skyterrace/Robot/MainBoard/Doc/MainBord_PortAssign.pdf

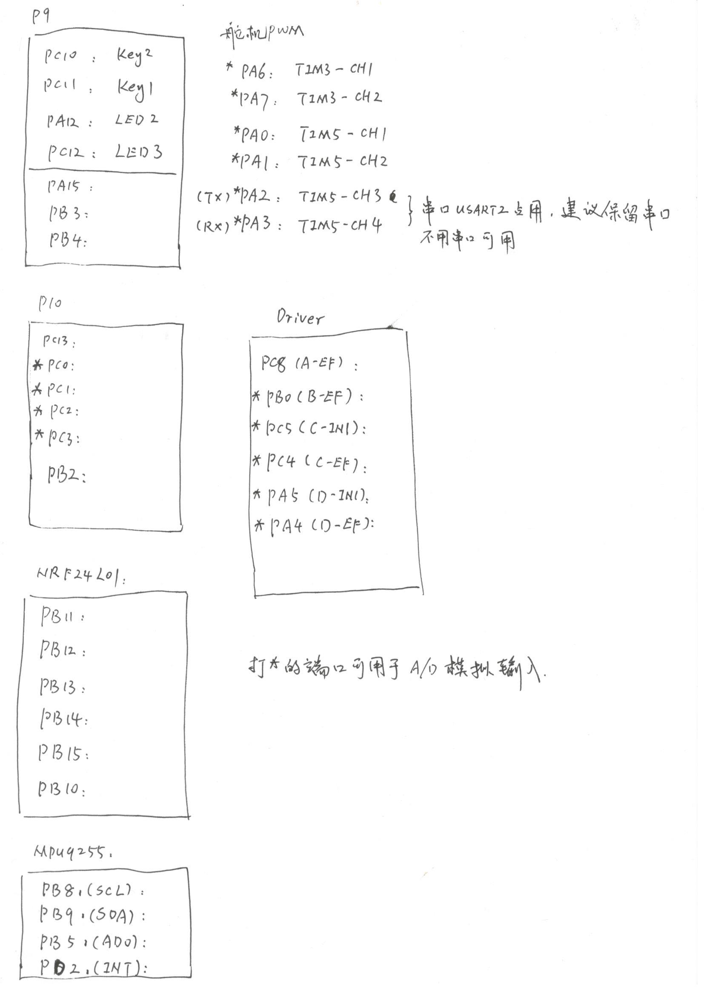
[picture p2: page 1]
