skyterrace/Robot/MainBoard/Hardware/MainBoardV2.PDF

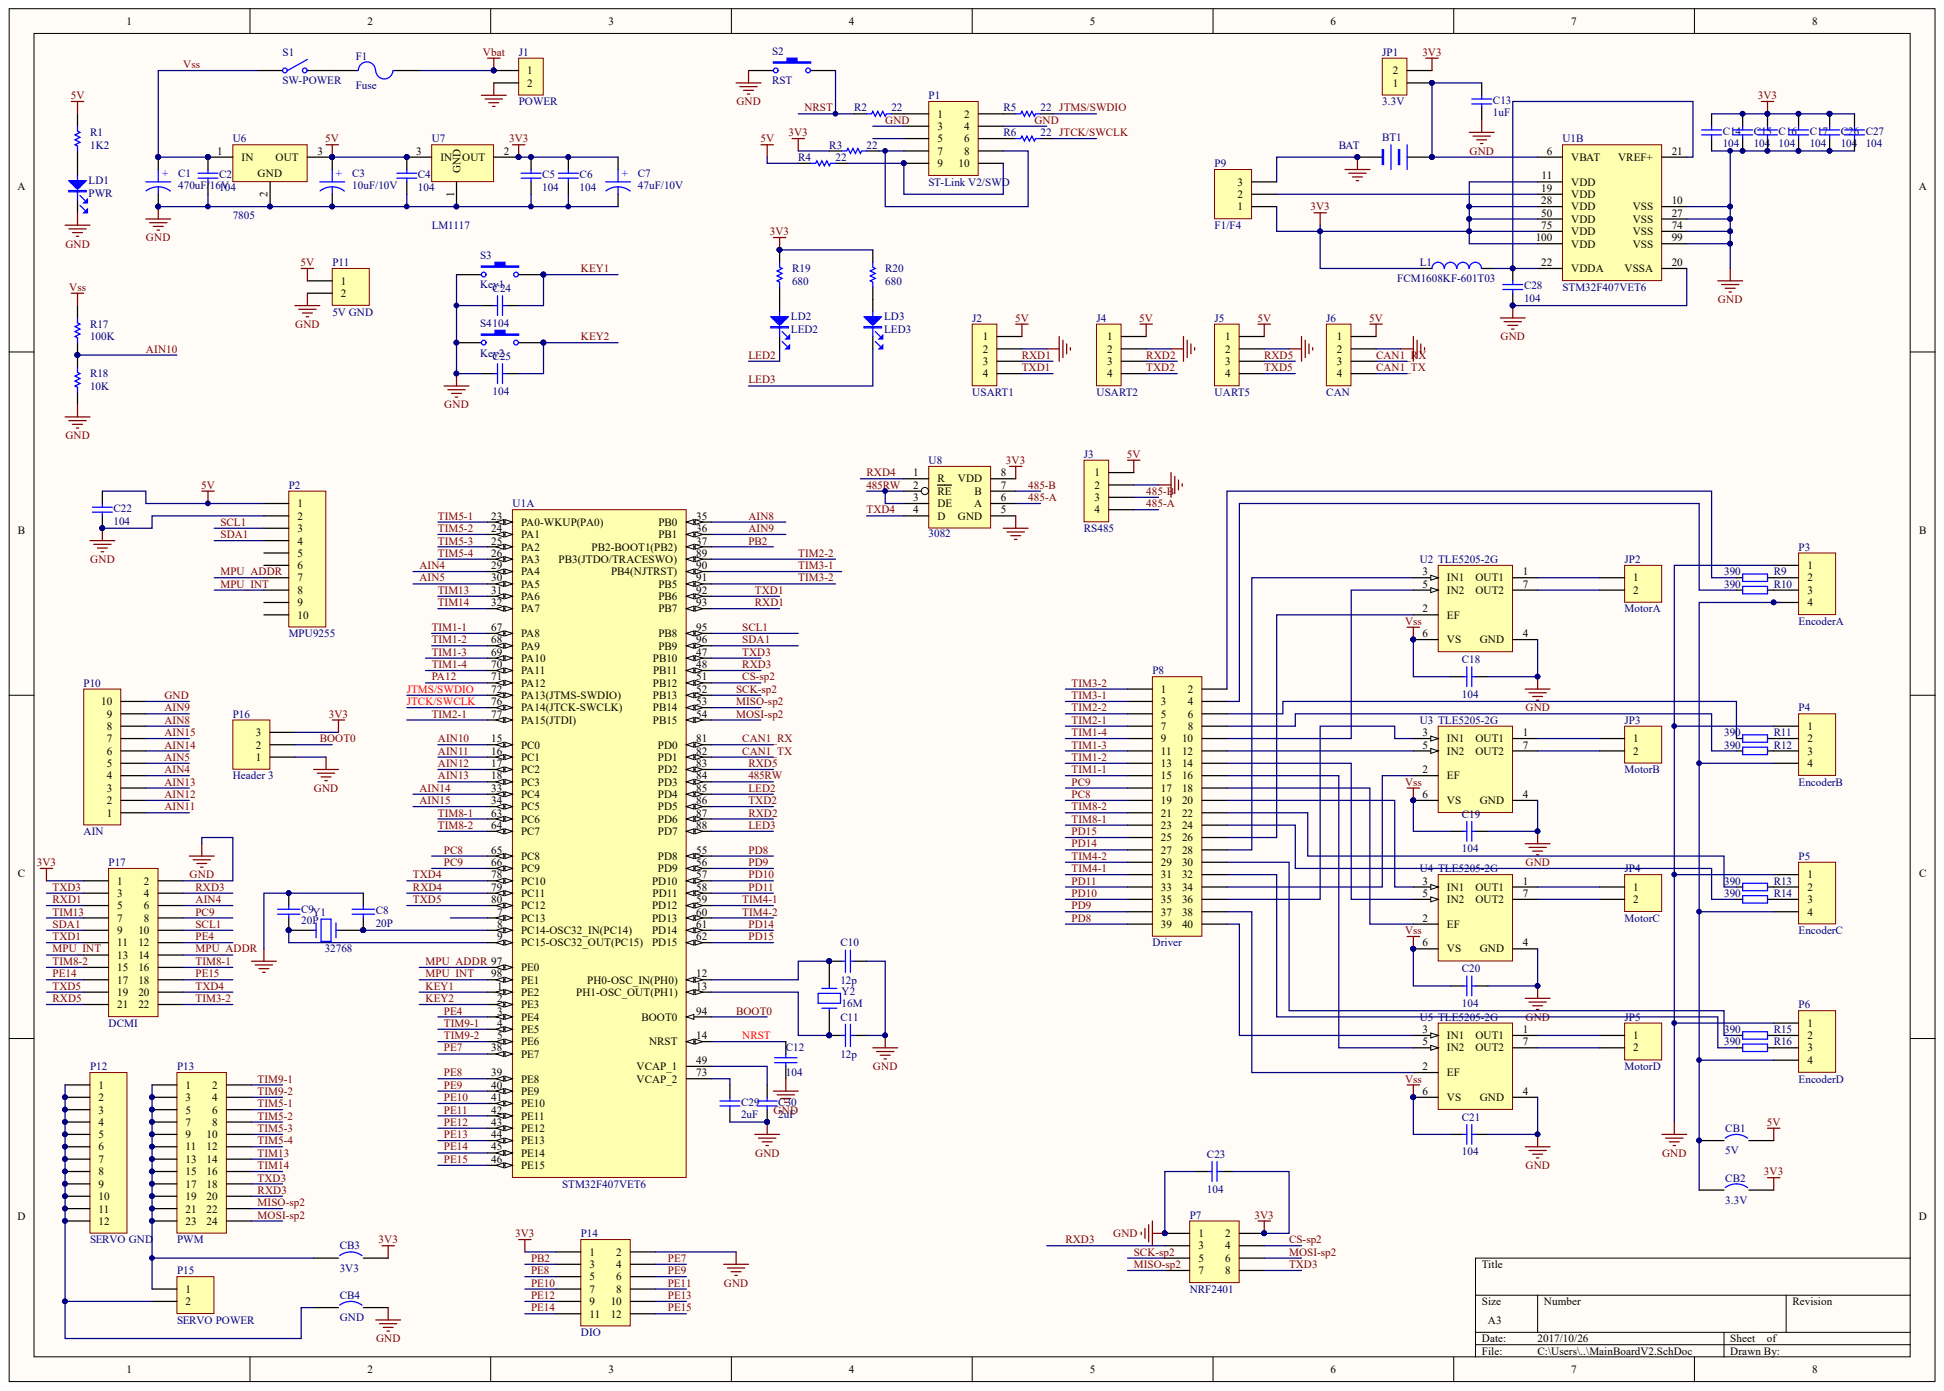
[picture p5: page 1]

VDD 50

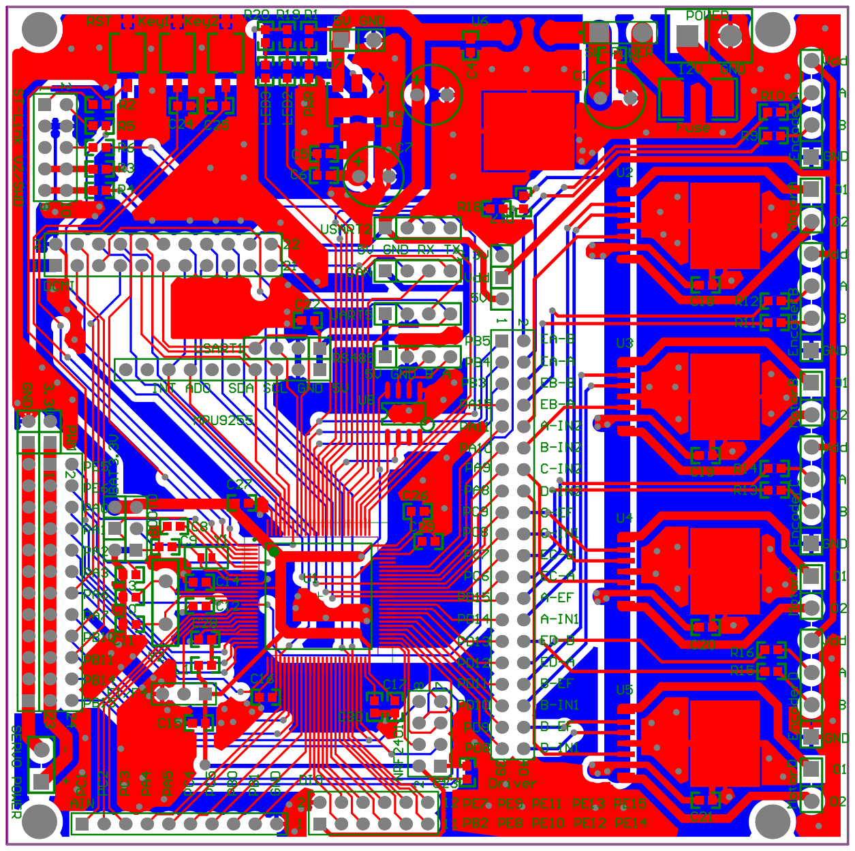
[picture p6: page 2]
