skyterrace/Robot/MainBoard/Hardware/MainBoard.PDF

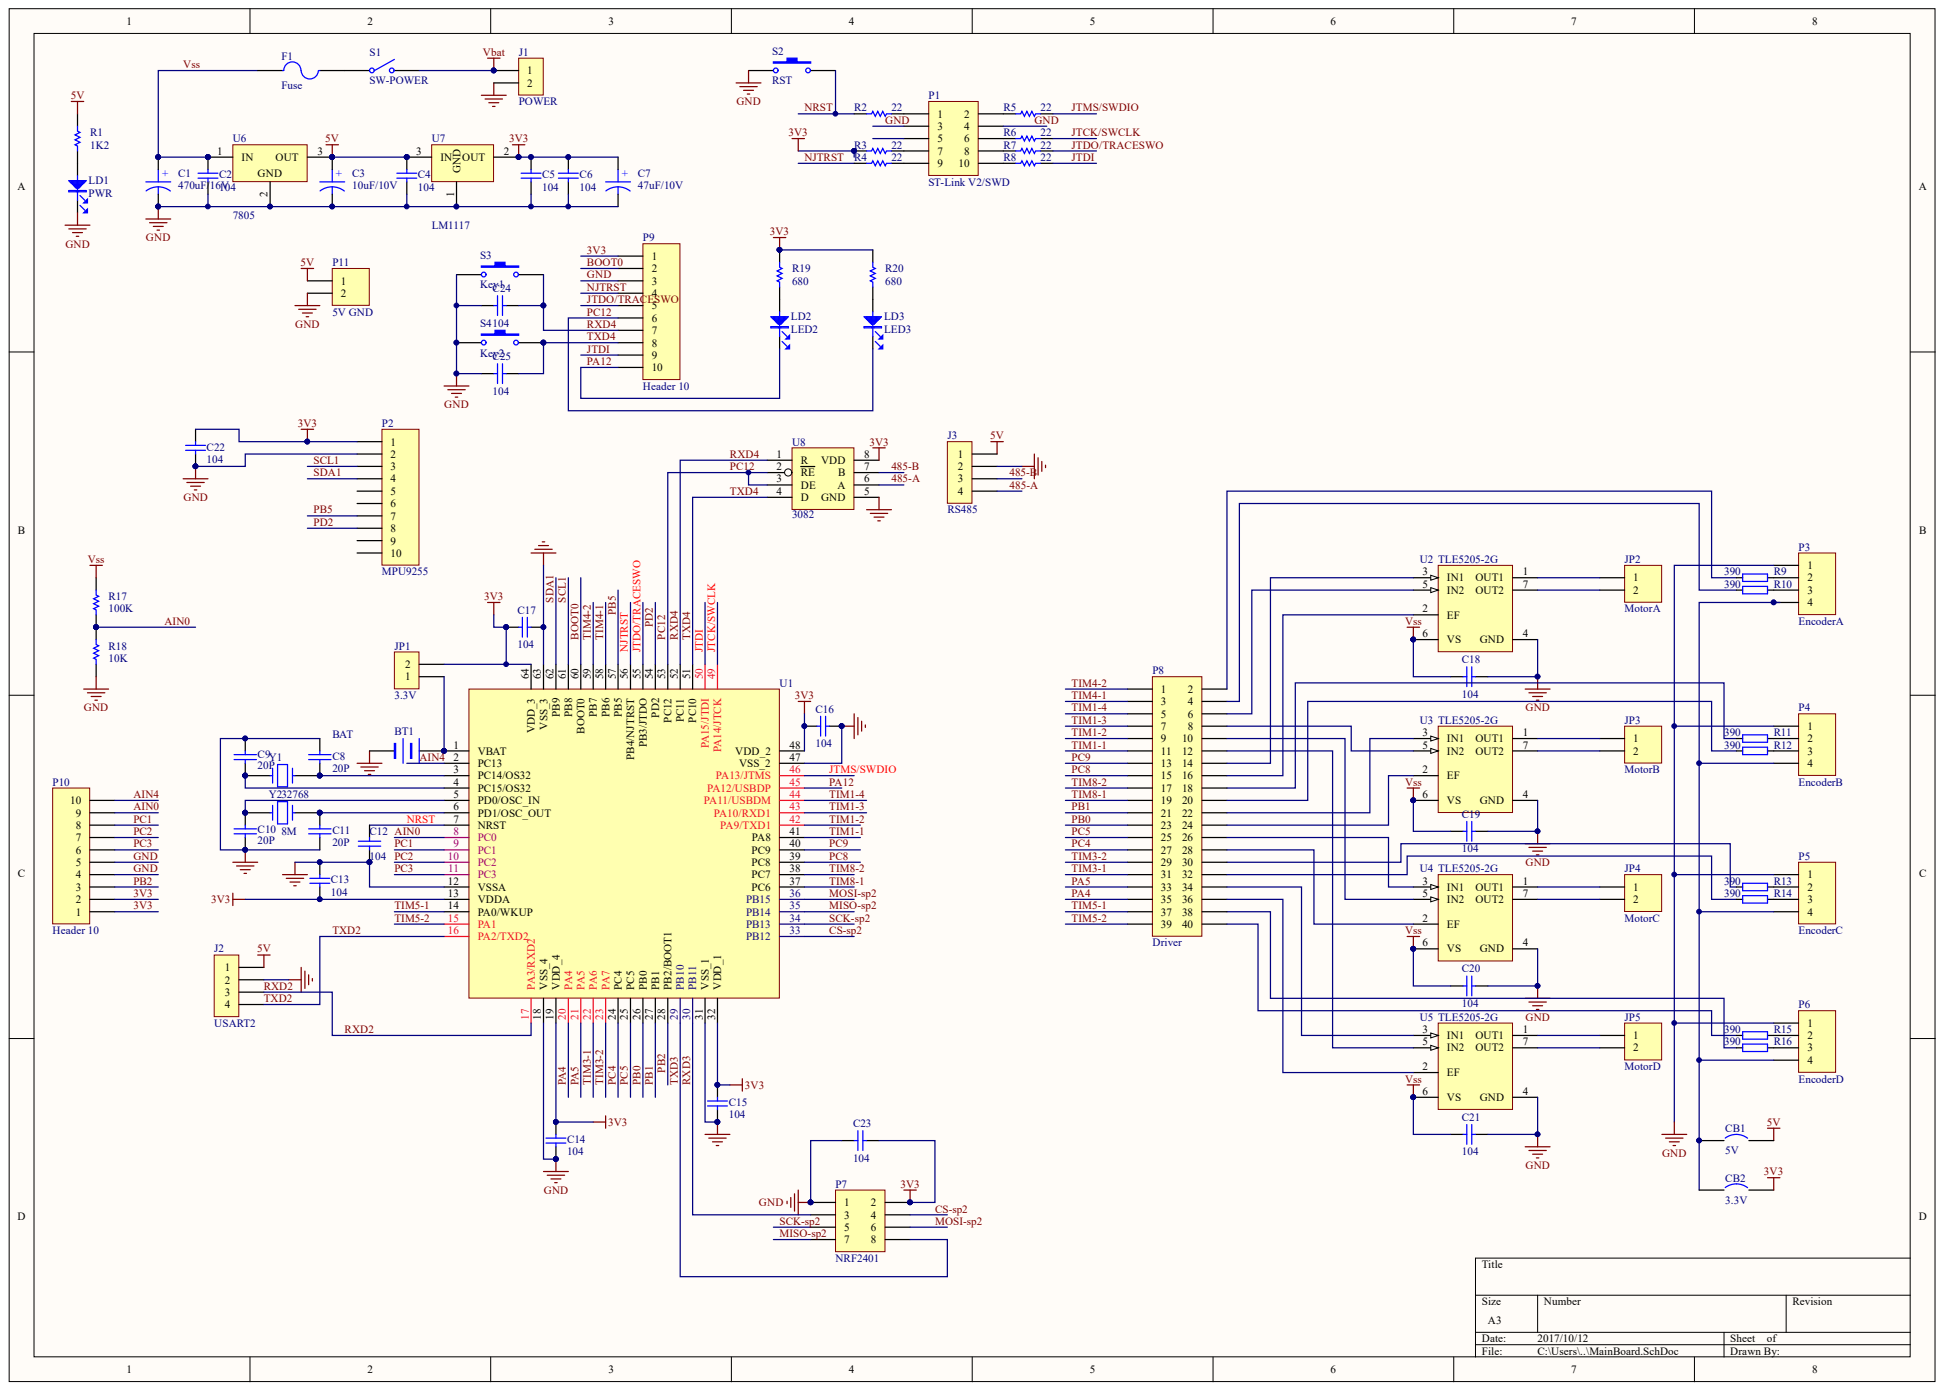
[picture p7: page 1]

PC12
RX D 4

JTD I | 10

104 SCL1

PA14/JTCK 49 PA15/JTDI 50 PC10 51 PC11 52 PC12 53 PD2 54 PB3/JTDO 55 PB4/NJTRST 56 PB5 57 PB6 58 PB7 59 BOOT0 60 PB8 61 PB9 62 VSS_3 63 VDD_3 64

RX D 2
TX D 2

U 5 TLE5205-2G G N D JP5

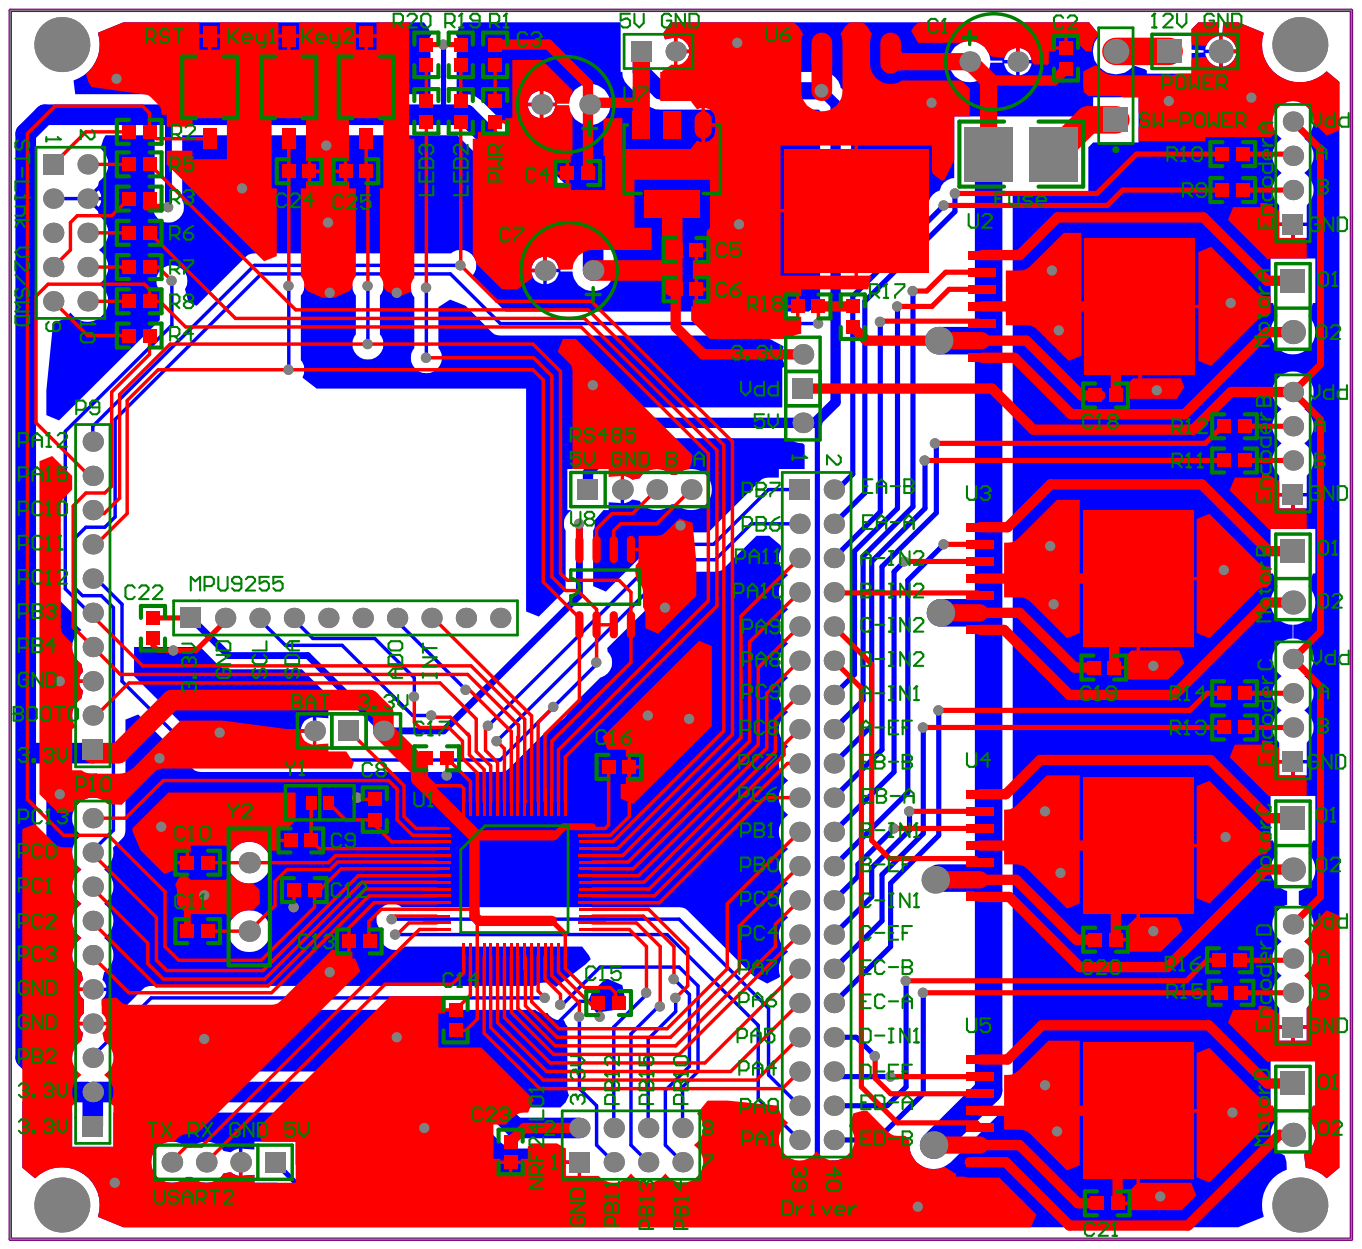
[picture p8: page 2]
