skyterrace/Robot/(list of files, drawings)

Other design files:
Driver/Driver.PcbDoc
Driver/Driver.PrjPCB
Driver/Driver.SchDoc
Driver/INF-PG-TO263-7-1L.PcbLib
MainBoard/Hardware/INF-PG-TO263-7-1L.PcbLib
MainBoard/Hardware/MainBoard.PcbDoc
MainBoard/Hardware/MainBoard.PrjPCB
MainBoard/Hardware/MainBoard.SchDoc
MainBoard/Hardware/MainBoardV2.PcbDoc
MainBoard/Hardware/MainBoardV2.PrjPCB
MainBoard/Hardware/MainBoardV2.SchDoc
MainBoard/Hardware/MainBoardV2.SCHLIB
MainBoard/Hardware/STM32MISC.PcbLib
MainBoard/Hardware/TCRT5000.PcbDoc
MainBoard/Hardware/TCRT5000.SchDoc
MainBoard/Hardware/TCRT5000COM.PcbDoc
MainBoard/Hardware/TCRT5000COM.PrjPCB
MainBoard/Hardware/TCRT5000COM.SchDoc
