skyterrace/Robot/MainBoard/Controller/STM32F103VC/User/MotorDriver.h

#ifndef __MOTORDRIVER_H
#define __MOTORDRIVER_H
#include "stm32f10x.h"

/*电机PWM驱动部分
使用TIM1四路PWM通道控制四个电机，PA11，PA10，PA9，PA8
电机A：IN1-PD14，IN2-PA11（TIM1-4），EF-PD15
电机B：IN1-PD10，IN2-PA10（TIM1-3），EF-PD11
电机C：IN1-PC8，IN2-PA9（TIM1-2），EF-PC9
电机D：IN1-PD8，IN2-PA8（TIM1-1），EF-PD9
*/
#define PWM_DUTY_LIMIT 8000  //PWM占空比范围0~10000，不能小于5000
void MotorDriver_Init(uint8_t nMotorCount); //初始化电机驱动，nMotorCount=1，初始化电机A，nMotor=2，初始化电机A和B，以此类推，从1到4
																			//初始化后，默认电机是停止的，需要用MotorDriver_Start启动电机																				
void MotorDriver_SetPWMDuty(uint8_t nMotor, uint16_t nDuty); //设置PWM占空比
void MotorDriver_Start(uint8_t nMotor, uint16_t nDuty); //启动电机，nMotor：电机序号，nDuty：初始转速，PWM_DUTY_LIMIT/2等于转速0 
void MotorDriver_Stop(uint8_t nMotor, uint16_t nDuty); //停止电机，nMotor：电机序号，nDuty：停止的速度，0相当于急刹车，数值越大停的越慢，最大不超过PWM_DUTY_LIMIT 
																											 //每次停止后，需要用MotorDriver_Start重新启动电机
uint8_t MotorDriver_GetMotorState(uint8_t nMotor); //获取电机nMotor的状态，0-运行状态，1-停止状态
																											 
/*编码器部分
使用了TIM3，TIM2，TIM8，TIM4
编码器A，A-PB4(TIM3-1)，B-PB5（TIM3-2）；需要remap
编码器B，A-PA15(TIM2-1)，B-PB3（TIM2-2）；需要remap
编码器C，A-PC6(TIM8-1)，B-PC7（TIM8-2）
编码器D，A-PD12(TIM4-1)，B-PD13（TIM4-2）；需要remap
*/
#define ENC_TIM_ARR 60000
void Encoder_Init(uint8_t nEncoderCount); //初始化编码器，nEncoderCount=1，初始化编码器A，=2，初始化编码器A和B，以此类推，从1到4
uint16_t Encoder_GetCNT(uint8_t nEncoder); //返回编码器的计数值，nEncoder=1返回编码器A，以此类推
int32_t Encoder_GetEncCount(uint8_t nEncoder);//返回编码器累计计数值，32位有符号值，正为正转，负为反转。最大大概20亿，长时间运行注意溢出。

#define Encoder_GetCNT1  TIM3->CNT
#define Encoder_GetCNT2  TIM2->CNT
#define Encoder_GetCNT3  TIM8->CNT
#define Encoder_GetCNT4  TIM4->CNT

#endif
