skyterrace/Robot/MainBoard/Controller/STM32F103VC/User/PCA9685.c

#include "PCA9685.h"
#include "math.h"
#include "delay.h"

uint8_t PCA9685_Buffer[2];

Status PCA9685_Init(void)
{
	NVIC_InitTypeDef NVIC_InitStructure;  //NVIC中断向量结构体

	NVIC_InitStructure.NVIC_IRQChannel = I2C1_EV_IRQn;					//配置I2C1EV中断
  NVIC_InitStructure.NVIC_IRQChannelPreemptionPriority = 3;
  NVIC_InitStructure.NVIC_IRQChannelSubPriority = 2;
  NVIC_InitStructure.NVIC_IRQChannelCmd = ENABLE;
  NVIC_Init(&NVIC_InitStructure); 
	
	NVIC_InitStructure.NVIC_IRQChannel = I2C1_ER_IRQn;					//配置I2C1ER中断 
  NVIC_InitStructure.NVIC_IRQChannelPreemptionPriority = 3;
  NVIC_InitStructure.NVIC_IRQChannelSubPriority = 2;
  NVIC_InitStructure.NVIC_IRQChannelCmd = ENABLE;
  NVIC_Init(&NVIC_InitStructure); 
	
	I2C_LowLevel_Init(PCA9685_I2C);
	Delay_ms(100);

	PCA9685_Reset();
	return Success;	
}

void PCA9685_Reset()
{
    PCA9685_write(PCA9685_MODE1,0x00);
}

void PCA9685_SetPWMFreq(float freq)
{
    uint32_t prescale,oldmode,newmode;
    float prescaleval;
    freq *= 0.92;  // Correct for overshoot in the frequency setting 
    prescaleval = 25000000;
    prescaleval /= 4096;
    prescaleval /= freq;
    prescaleval -= 1;
    prescale = floor(prescaleval + 0.5);

    oldmode = PCA9685_read(PCA9685_MODE1);
    newmode = (oldmode&0x7F) | 0x10; // sleep
    PCA9685_write(PCA9685_MODE1, newmode); // go to sleep
    PCA9685_write(PCA9685_PRESCALE, prescale); // set the prescaler
    PCA9685_write(PCA9685_MODE1, oldmode);
    PCA9685_write(PCA9685_MODE1, oldmode | 0xa1);

}
void PCA9685_SetPWM(uint8_t num,uint16_t on,uint16_t off)
{
    PCA9685_write(LED0_ON_L+4*num,on);
    PCA9685_write(LED0_ON_H+4*num,on>>8);
    PCA9685_write(LED0_OFF_L+4*num,off);
    PCA9685_write(LED0_OFF_H+4*num,off>>8);
}

uint8_t PCA9685_read(uint8_t startAddress) {
    //Send address to start reading from.
    uint8_t tx[1];
    uint8_t buffer[1];
    tx[0]=startAddress;
    //HAL_I2C_Master_Transmit(&hi2c2,PCA9685_adrr, tx,1,10000);
    //HAL_I2C_Master_Receive(&hi2c2,PCA9685_adrr,buffer,1,10000);
	  I2C_Master_BufferWrite(PCA9685_I2C, tx,1,Polling, PCA9685_Addr);
		I2C_Master_BufferRead(PCA9685_I2C,buffer,1,Polling, PCA9685_Addr);		
    return buffer[0];
}

void PCA9685_write(uint8_t startAddress, uint8_t buffer) {
    //Send address to start reading from.
    uint8_t tx[2];
    tx[0]=startAddress;
    tx[1]=buffer;
    //HAL_I2C_Master_Transmit(&hi2c2,PCA9685_adrr, tx,2,10000);
		I2C_Master_BufferWrite(PCA9685_I2C, tx,2,Polling, PCA9685_Addr);

}
