skyterrace/Robot/(commit log)

2017-10-10 New Repo
    [Driver.PcbDoc, Driver.PrjPCB, Driver.SchDoc, INF-PG-TO263-7-1L.PcbLib, MainBoard.PcbDoc, MainBoard.PrjPCB, MainBoard.SchDoc, STM32MISC.PcbLib]
2017-10-15 Add STM32 Controller Projects
    Add STM32 Controller Projects
    Add Hardware Setup Guide
2017-10-17 Add MPU6050 Support
    eMPL，MPU6050DMP，I2CRoutines
    other minor revision.
2017-10-18 Fixed MPU6050 Errors
    Now MPU6050 is working.
    [BTModule.c, I2CRoutines.c, MPU6050DMP.c, MPU6050DMP.h, MotorController.c, MotorController.h, main.c]
2017-10-19 Fix MPU6050 and TIM8 issues
    because enable MicroLIB to solve the dmp problem, the TIM8 UP IRQ
    Handler doesnt work. now they are work.
    [MPU6050DMP.c, MPU6050DMP.h, main.c]
2017-10-20 Fixed the TIM8 IRQ Problem
    because TIM8 repetition counter has not been initialize, the RCR
    register has random value. if RCR is zero it works, while RCR is not
    zero it works incorrectly. now we initialize the RCR with zero, it
    works.
    [MotorDriver.c]
2017-10-25 Add MainBoard Hardware V2
    using STM32F103 or STM32F407/427 100 Pins MCU
    [MainBoardV2.PcbDoc, MainBoardV2.PrjPCB, MainBoardV2.SchDoc, STM32MISC.PcbLib]
2017-10-26 MainBoard Hardware V2 minor revision
    [MainBoardV2.PcbDoc]
2017-12-18 Add two 100pins CPU projects
    103VC and 407VE
    [MainBoardV2.PcbDoc, MainBoardV2.SchDoc]
2017-12-19 Update 103VC Project
    Fixed the port assignment.
    Add ADIN.h/c
    Add ServoMotor.h/c
    [ADIN.c, ADIN.h, BTModule.h, I2CRoutines.c, KeyLed.h, MotorDriver.c, MotorDriver.h, ServoMotor.c]
2017-12-20 Fixed Speed Controller & ServoMotor
    [ADIN.c, MotorController.c, MotorController.h, MotorDriver.c, MotorDriver.h, ServoMotor.c, main.c]
2018-02-02 Add support for DRS3100 sensor
    DRS3100 in F407VE
2018-07-13 Add Vision Directory
    [MainBoardV2.PrjPCB, MainBoardV2.SCHLIB, STM32MISC.PcbLib, TCRT5000.PcbDoc, TCRT5000.SchDoc]
2018-09-06 Add TCRT5000 Line Detector Hardware Project
    TCRT5000 for Line Detect, Schematic and PCB file.
    [MainBoardV2.SchDoc, STM32MISC.PcbLib, TCRT5000COM.PcbDoc, TCRT5000COM.PrjPCB, TCRT5000COM.SchDoc]
2018-10-16 Minor Revision
    [MainBoardV2.PrjPCB, STM32MISC.PcbLib, TCRT5000.PcbDoc, TCRT5000COM.PcbDoc, TCRT5000COM.PrjPCB, TCRT5000COM.SchDoc]
2018-11-09 Remove DCMI Camera
    Remove DCMI Camera
    [MainBoardV2.PcbDoc, MainBoardV2.SchDoc]
